peter-morken/kids-disc-player/cad/stl/housing.stl

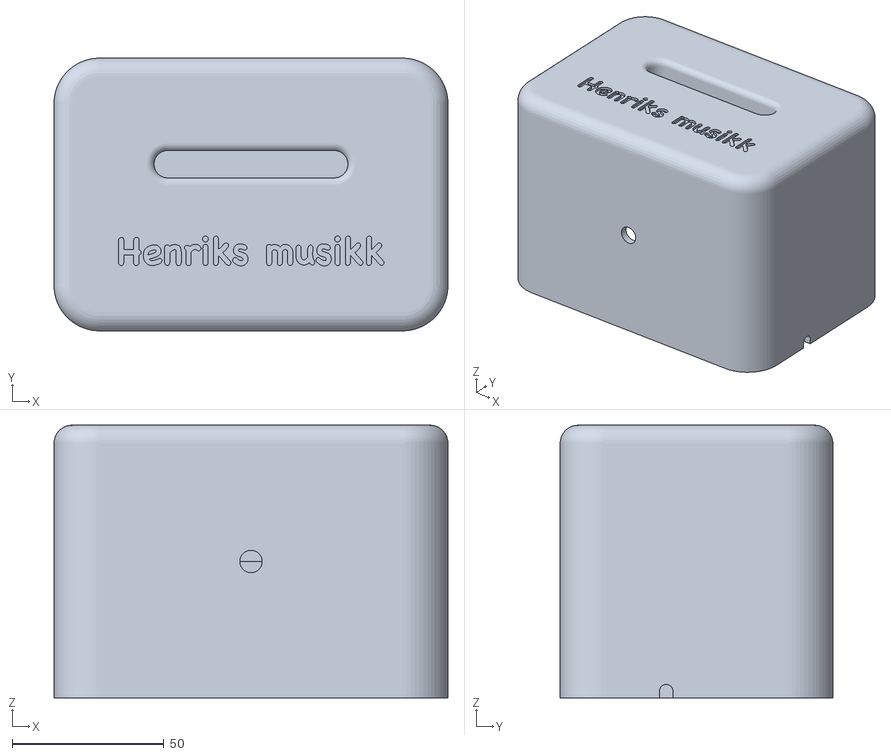
[picture p1: CAD file, 2026-11-07]
cad/stl/housing.stl
130.0 x 90.0 x 90.0
