peter-morken/kids-disc-player/cad/toddler-music-box.step

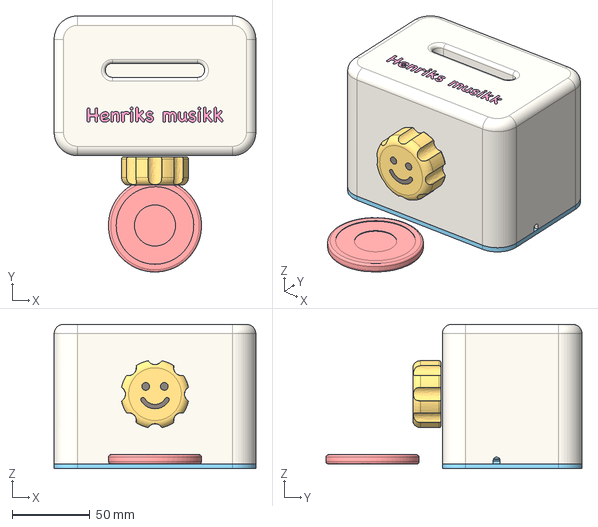
[picture p2: CAD file, 2026-11-07]
cad/toddler-music-box.step
130.0 x 165.0 x 93.0 mm
