peter-morken/kids-disc-player/cad/stl/name-text.stl

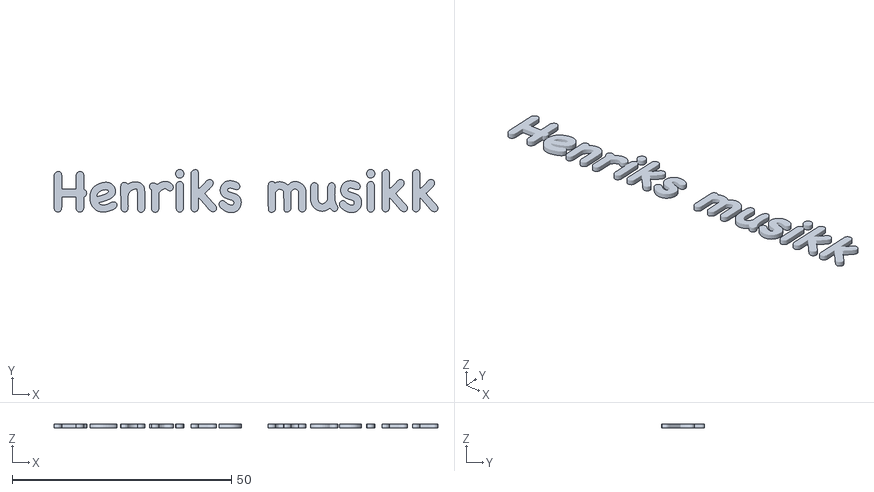
[picture p3: CAD file, 2026-11-07]
cad/stl/name-text.stl
87.7 x 9.89 x 1.00
