peter-morken/kids-disc-player/cad/stl/knob-face.stl

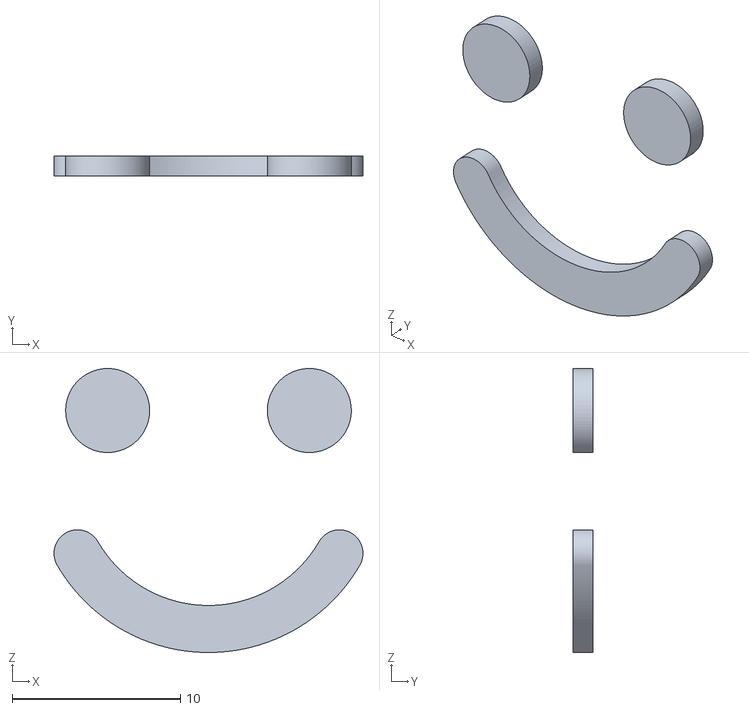
[picture p4: CAD file, 2026-11-07]
cad/stl/knob-face.stl
18.4 x 1.20 x 16.9
