peter-morken/kids-disc-player/cad/stl/knob.stl

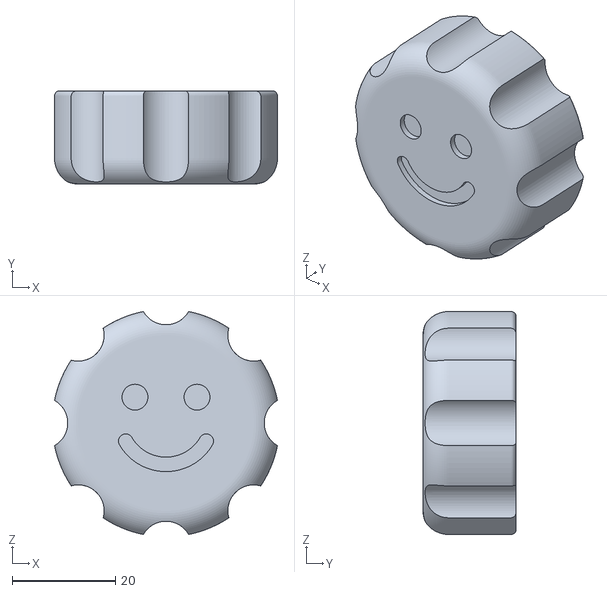
[picture p5: CAD file, 2026-11-07]
cad/stl/knob.stl
43.1 x 18.0 x 43.1
