peter-morken/kids-disc-player/cad/stl/base.stl

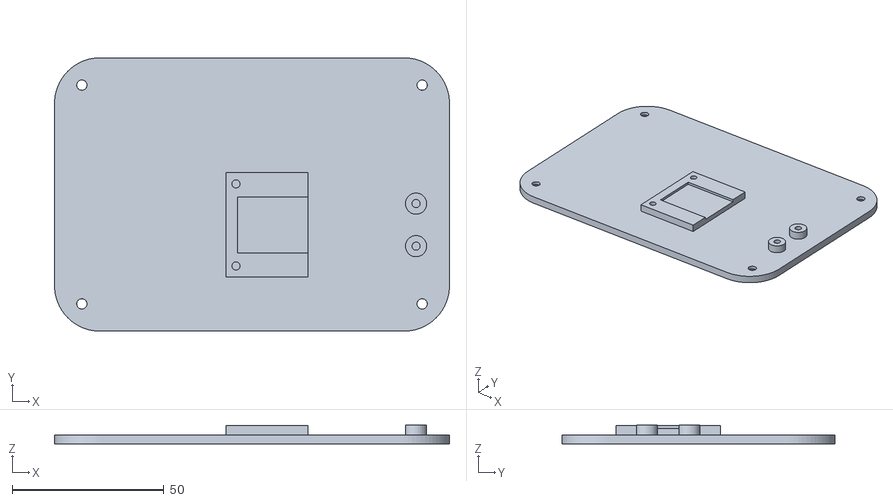
[picture p6: CAD file, 2026-11-07]
cad/stl/base.stl
130.0 x 90.0 x 6.20
