peter-morken/kids-disc-player/cad/stl/disc.stl

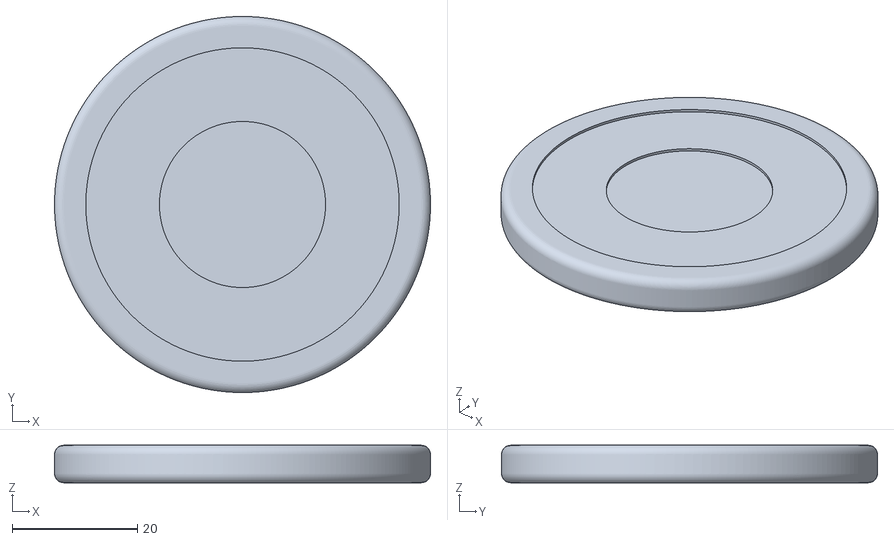
[picture p7: CAD file, 2026-11-07]
cad/stl/disc.stl
60.0 x 60.0 x 6.00
