peter-morken/kids-disc-player/cad/stl/cable-clamp.stl

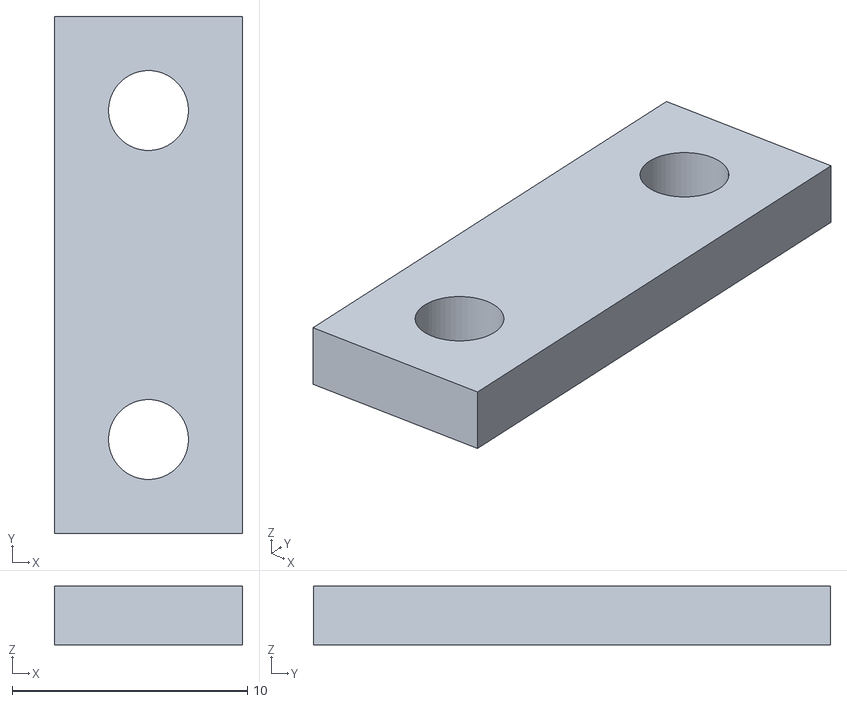
[picture p8: CAD file, 2026-11-07]
cad/stl/cable-clamp.stl
8.00 x 22.0 x 2.50
