peter-morken/kids-disc-player/cad/stl/esp-clamp.stl

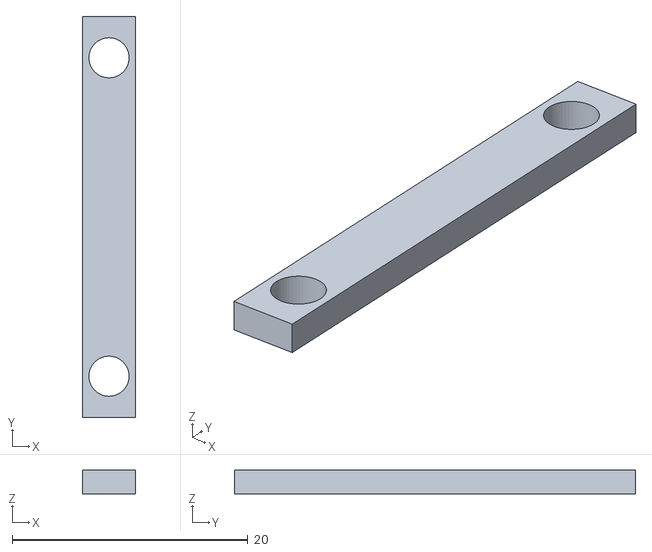
[picture p9: CAD file, 2026-11-07]
cad/stl/esp-clamp.stl
4.50 x 34.0 x 2.00
