peter-morken/kids-disc-player/(list of files, cad)

Other CAD files:
cad/toddler-music-box.3mf
