peter-morken/kids-disc-player/firmware/src/github_root_cas.h

#pragma once
// Root CAs trusted for firmware downloads from GitHub Releases.
// github.com and its release-asset CDN currently chain to Sectigo/USERTrust
// or DigiCert. The others are there so a change of CA by GitHub does not cut
// a device in the field off from updates. Source: Mozilla root store
// (Debian ca-certificates). Regenerate with tools/gen_root_cas.sh.

static const char kGithubRootCAs[] =
    // USERTrust_ECC_Certification_Authority
    "-----BEGIN CERTIFICATE-----\n"
    "MIICjzCCAhWgAwIBAgIQXIuZxVqUxdJxVt7NiYDMJjAKBggqhkjOPQQDAzCBiDEL\n"
    "MAkGA1UEBhMCVVMxEzARBgNVBAgTCk5ldyBKZXJzZXkxFDASBgNVBAcTC0plcnNl\n"
    "eSBDaXR5MR4wHAYDVQQKExVUaGUgVVNFUlRSVVNUIE5ldHdvcmsxLjAsBgNVBAMT\n"
    "JVVTRVJUcnVzdCBFQ0MgQ2VydGlmaWNhdGlvbiBBdXRob3JpdHkwHhcNMTAwMjAx\n"
    "MDAwMDAwWhcNMzgwMTE4MjM1OTU5WjCBiDELMAkGA1UEBhMCVVMxEzARBgNVBAgT\n"
    "Ck5ldyBKZXJzZXkxFDASBgNVBAcTC0plcnNleSBDaXR5MR4wHAYDVQQKExVUaGUg\n"
    "VVNFUlRSVVNUIE5ldHdvcmsxLjAsBgNVBAMTJVVTRVJUcnVzdCBFQ0MgQ2VydGlm\n"
    "aWNhdGlvbiBBdXRob3JpdHkwdjAQBgcqhkjOPQIBBgUrgQQAIgNiAAQarFRaqflo\n"
    "I+d61SRvU8Za2EurxtW20eZzca7dnNYMYf3boIkDuAUU7FfO7l0/4iGzzvfUinng\n"
    "o4N+LZfQYcTxmdwlkWOrfzCjtHDix6EznPO/LlxTsV+zfTJ/ijTjeXmjQjBAMB0G\n"
    "A1UdDgQWBBQ64QmG1M8ZwpZ2dEl23OA1xmNjmjAOBgNVHQ8BAf8EBAMCAQYwDwYD\n"
    "VR0TAQH/BAUwAwEB/zAKBggqhkjOPQQDAwNoADBlAjA2Z6EWCNzklwBBHU6+4WMB\n"
    "zzuqQhFkoJ2UOQIReVx7Hfpkue4WQrO/isIJxOzksU0CMQDpKmFHjFJKS04YcPbW\n"
    "RNZu9YO6bVi9JNlWSOrvxKJGgYhqOkbRqZtNyWHa0V1Xahg=\n"
    "-----END CERTIFICATE-----\n"
    // USERTrust_RSA_Certification_Authority
    "-----BEGIN CERTIFICATE-----\n"
    "MIIF3jCCA8agAwIBAgIQAf1tMPyjylGoG7xkDjUDLTANBgkqhkiG9w0BAQwFADCB\n"
    "iDELMAkGA1UEBhMCVVMxEzARBgNVBAgTCk5ldyBKZXJzZXkxFDASBgNVBAcTC0pl\n"
    "cnNleSBDaXR5MR4wHAYDVQQKExVUaGUgVVNFUlRSVVNUIE5ldHdvcmsxLjAsBgNV\n"
    "BAMTJVVTRVJUcnVzdCBSU0EgQ2VydGlmaWNhdGlvbiBBdXRob3JpdHkwHhcNMTAw\n"
    "MjAxMDAwMDAwWhcNMzgwMTE4MjM1OTU5WjCBiDELMAkGA1UEBhMCVVMxEzARBgNV\n"
    "BAgTCk5ldyBKZXJzZXkxFDASBgNVBAcTC0plcnNleSBDaXR5MR4wHAYDVQQKExVU\n"
    "aGUgVVNFUlRSVVNUIE5ldHdvcmsxLjAsBgNVBAMTJVVTRVJUcnVzdCBSU0EgQ2Vy\n"
    "dGlmaWNhdGlvbiBBdXRob3JpdHkwggIiMA0GCSqGSIb3DQEBAQUAA4ICDwAwggIK\n"
    "AoICAQCAEmUXNg7D2wiz0KxXDXbtzSfTTK1Qg2HiqiBNCS1kCdzOiZ/MPans9s/B\n"
    "3PHTsdZ7NygRK0faOca8Ohm0X6a9fZ2jY0K2dvKpOyuR+OJv0OwWIJAJPuLodMkY\n"
    "tJHUYmTbf6MG8YgYapAiPLz+E/CHFHv25B+O1ORRxhFnRghRy4YUVD+8M/5+bJz/\n"
    "Fp0YvVGONaanZshyZ9shZrHUm3gDwFA66Mzw3LyeTP6vBZY1H1dat//O+T23LLb2\n"
    "VN3I5xI6Ta5MirdcmrS3ID3KfyI0rn47aGYBROcBTkZTmzNg95S+UzeQc0PzMsNT\n"
    "79uq/nROacdrjGCT3sTHDN/hMq7MkztReJVni+49Vv4M0GkPGw/zJSZrM233bkf6\n"
    "c0Plfg6lZrEpfDKEY1WJxA3Bk1QwGROs0303p+tdOmw1XNtB1xLaqUkL39iAigmT\n"
    "Yo61Zs8liM2EuLE/pDkP2QKe6xJMlXzzawWpXhaDzLhn4ugTncxbgtNMs+1b/97l\n"
    "c6wjOy0AvzVVdAlJ2ElYGn+SNuZRkg7zJn0cTRe8yexDJtC/QV9AqURE9JnnV4ee\n"
    "UB9XVKg+/XRjL7FQZQnmWEIuQxpMtPAlR1n6BB6T1CZGSlCBst6+eLf8ZxXhyVeE\n"
    "Hg9j1uliutZfVS7qXMYoCAQlObgOK6nyTJccBz8NUvXt7y+CDwIDAQABo0IwQDAd\n"
    "BgNVHQ4EFgQUU3m/WqorSs9UgOHYm8Cd8rIDZsswDgYDVR0PAQH/BAQDAgEGMA8G\n"
    "A1UdEwEB/wQFMAMBAf8wDQYJKoZIhvcNAQEMBQADggIBAFzUfA3P9wF9QZllDHPF\n"
    "Up/L+M+ZBn8b2kMVn54CVVeWFPFSPCeHlCjtHzoBN6J2/FNQwISbxmtOuowhT6KO\n"
    "VWKR82kV2LyI48SqC/3vqOlLVSoGIG1VeCkZ7l8wXEskEVX/JJpuXior7gtNn3/3\n"
    "ATiUFJVDBwn7YKnuHKsSjKCaXqeYalltiz8I+8jRRa8YFWSQEg9zKC7F4iRO/Fjs\n"
    "8PRF/iKz6y+O0tlFYQXBl2+odnKPi4w2r78NBc5xjeambx9spnFixdjQg3IM8WcR\n"
    "iQycE0xyNN+81XHfqnHd4blsjDwSXWXavVcStkNr/+XeTWYRUc+ZruwXtuhxkYze\n"
    "Sf7dNXGiFSeUHM9h4ya7b6NnJSFd5t0dCy5oGzuCr+yDZ4XUmFF0sbmZgIn/f3gZ\n"
    "XHlKYC6SQK5MNyosycdiyA5d9zZbyuAlJQG03RoHnHcAP9Dc1ew91Pq7P8yF1m9/\n"
    "qS3fuQL39ZeatTXaw2ewh0qpKJ4jjv9cJ2vhsE/zB+4ALtRZh8tSQZXq9EfX7mRB\n"
    "VXyNWQKV3WKdwrnuWih0hKWbt5DHDAff9Yk2dDLWKMGwsAvgnEzDHNb842m1R0aB\n"
    "L6KCq9NjRHDEjf8tM7qtj3u1cIiuPhnPQCjY/MiQu12ZIvVS5ljFH4gxQ+6IHdfG\n"
    "jjxDah2nGN59PRbxYvnKkKj9\n"
    "-----END CERTIFICATE-----\n"
    // Sectigo_Public_Server_Authentication_Root_E46
    "-----BEGIN CERTIFICATE-----\n"
    "MIICOjCCAcGgAwIBAgIQQvLM2htpN0RfFf51KBC49DAKBggqhkjOPQQDAzBfMQsw\n"
    "CQYDVQQGEwJHQjEYMBYGA1UEChMPU2VjdGlnbyBMaW1pdGVkMTYwNAYDVQQDEy1T\n"
    "ZWN0aWdvIFB1YmxpYyBTZXJ2ZXIgQXV0aGVudGljYXRpb24gUm9vdCBFNDYwHhcN\n"
    "MjEwMzIyMDAwMDAwWhcNNDYwMzIxMjM1OTU5WjBfMQswCQYDVQQGEwJHQjEYMBYG\n"
    "A1UEChMPU2VjdGlnbyBMaW1pdGVkMTYwNAYDVQQDEy1TZWN0aWdvIFB1YmxpYyBT\n"
    "ZXJ2ZXIgQXV0aGVudGljYXRpb24gUm9vdCBFNDYwdjAQBgcqhkjOPQIBBgUrgQQA\n"
    "IgNiAAR2+pmpbiDt+dd34wc7qNs9Xzjoq1WmVk/WSOrsfy2qw7LFeeyZYX8QeccC\n"
    "WvkEN/U0NSt3zn8gj1KjAIns1aeibVvjS5KToID1AZTc8GgHHs3u/iVStSBDHBv+\n"
    "6xnOQ6OjQjBAMB0GA1UdDgQWBBTRItpMWfFLXyY4qp3W7usNw/upYTAOBgNVHQ8B\n"
    "Af8EBAMCAYYwDwYDVR0TAQH/BAUwAwEB/zAKBggqhkjOPQQDAwNnADBkAjAn7qRa\n"
    "qCG76UeXlImldCBteU/IvZNeWBj7LRoAasm4PdCkT0RHlAFWovgzJQxC36oCMB3q\n"
    "4S6ILuH5px0CMk7yn2xVdOOurvulGu7t0vzCAxHrRVxgED1cf5kDW21USAGKcw==\n"
    "-----END CERTIFICATE-----\n"
    // Sectigo_Public_Server_Authentication_Root_R46
    "-----BEGIN CERTIFICATE-----\n"
    "MIIFijCCA3KgAwIBAgIQdY39i658BwD6qSWn4cetFDANBgkqhkiG9w0BAQwFADBf\n"
    "MQswCQYDVQQGEwJHQjEYMBYGA1UEChMPU2VjdGlnbyBMaW1pdGVkMTYwNAYDVQQD\n"
    "Ey1TZWN0aWdvIFB1YmxpYyBTZXJ2ZXIgQXV0aGVudGljYXRpb24gUm9vdCBSNDYw\n"
    "HhcNMjEwMzIyMDAwMDAwWhcNNDYwMzIxMjM1OTU5WjBfMQswCQYDVQQGEwJHQjEY\n"
    "MBYGA1UEChMPU2VjdGlnbyBMaW1pdGVkMTYwNAYDVQQDEy1TZWN0aWdvIFB1Ymxp\n"
    "YyBTZXJ2ZXIgQXV0aGVudGljYXRpb24gUm9vdCBSNDYwggIiMA0GCSqGSIb3DQEB\n"
    "AQUAA4ICDwAwggIKAoICAQCTvtU2UnXYASOgHEdCSe5jtrch/cSV1UgrJnwUUxDa\n"
    "ef0rty2k1Cz66jLdScK5vQ9IPXtamFSvnl0xdE8H/FAh3aTPaE8bEmNtJZlMKpnz\n"
    "SDBh+oF8HqcIStw+KxwfGExxqjWMrfhu6DtK2eWUAtaJhBOqbchPM8xQljeSM9xf\n"
    "iOefVNlI8JhD1mb9nxc4Q8UBUQvX4yMPFF1bFOdLvt30yNoDN9HWOaEhUTCDsG3X\n"
    "ME6WW5HwcCSrv0WBZEMNvSE6Lzzpng3LILVCJ8zab5vuZDCQOc2TZYEhMbUjUDM3\n"
    "IuM47fgxMMxF/mL50V0yeUKH32rMVhlATc6qu/m1dkmU8Sf4kaWD5QazYw6A3OAS\n"
    "VYCmO2a0OYctyPDQ0RTp5A1NDvZdV3LFOxxHVp3i1fuBYYzMTYCQNFu31xR13NgE\n"
    "SJ/AwSiItOkcyqex8Va3e0lMWeUgFaiEAin6OJRpmkkGj80feRQXEgyDet4fsZfu\n"
    "+Zd4KKTIRJLpfSYFplhym3kT2BFfrsU4YjRosoYwjviQYZ4ybPUHNs2iTG7sijbt\n"
    "8uaZFURww3y8nDnAtOFr94MlI1fZEoDlSfB1D++N6xybVCi0ITz8fAr/73trdf+L\n"
    "HaAZBav6+CuBQug4urv7qv094PPK306Xlynt8xhW6aWWrL3DkJiy4Pmi1KZHQ3xt\n"
    "zwIDAQABo0IwQDAdBgNVHQ4EFgQUVnNYZJX5khqwEioEYnmhQBWIIUkwDgYDVR0P\n"
    "AQH/BAQDAgGGMA8GA1UdEwEB/wQFMAMBAf8wDQYJKoZIhvcNAQEMBQADggIBAC9c\n"
    "mTz8Bl6MlC5w6tIyMY208FHVvArzZJ8HXtXBc2hkeqK5Duj5XYUtqDdFqij0lgVQ\n"
    "YKlJfp/imTYpE0RHap1VIDzYm/EDMrraQKFz6oOht0SmDpkBm+S8f74TlH7Kph52\n"
    "gDY9hAaLMyZlbcp+nv4fjFg4exqDsQ+8FxG75gbMY/qB8oFM2gsQa6H61SilzwZA\n"
    "Fv97fRheORKkU55+MkIQpiGRqRxOF3yEvJ+M0ejf5lG5Nkc/kLnHvALcWxxPDkjB\n"
    "JYOcCj+esQMzEhonrPcibCTRAUH4WAP+JWgiH5paPHxsnnVI84HxZmduTILA7rpX\n"
    "DhjvLpr3Etiga+kFpaHpaPi8TD8SHkXoUsCjvxInebnMMTzD9joiFgOgyY9mpFui\n"
    "TdaBJQbpdqQACj7LzTWb4OE4y2BThihCQRxEV+ioratF4yUQvNs+ZUH7G6aXD+u5\n"
    "dHn5HrwdVw1Hr8Mvn4dGp+smWg9WY7ViYG4A++MnESLn/pmPNPW56MORcr3Ywx65\n"
    "LvKRRFHQV80MNNVIIb/bE/FmJUNS0nAiNs2fxBx1IK1jcmMGDw4nztJqDby1ORrp\n"
    "0XZ60Vzk50lJLVU3aPAaOpg+VBeHVOmmJ1CJeyAvP/+/oYtKR5j/K3tJPsMpRmAY\n"
    "QqszKbrAKbkTidOIijlBO8n9pu0f9GBj39ItVQGL\n"
    "-----END CERTIFICATE-----\n"
    // DigiCert_Global_Root_G2
    "-----BEGIN CERTIFICATE-----\n"
    "MIIDjjCCAnagAwIBAgIQAzrx5qcRqaC7KGSxHQn65TANBgkqhkiG9w0BAQsFADBh\n"
    "MQswCQYDVQQGEwJVUzEVMBMGA1UEChMMRGlnaUNlcnQgSW5jMRkwFwYDVQQLExB3\n"
    "d3cuZGlnaWNlcnQuY29tMSAwHgYDVQQDExdEaWdpQ2VydCBHbG9iYWwgUm9vdCBH\n"
    "MjAeFw0xMzA4MDExMjAwMDBaFw0zODAxMTUxMjAwMDBaMGExCzAJBgNVBAYTAlVT\n"
    "MRUwEwYDVQQKEwxEaWdpQ2VydCBJbmMxGTAXBgNVBAsTEHd3dy5kaWdpY2VydC5j\n"
    "b20xIDAeBgNVBAMTF0RpZ2lDZXJ0IEdsb2JhbCBSb290IEcyMIIBIjANBgkqhkiG\n"
    "9w0BAQEFAAOCAQ8AMIIBCgKCAQEAuzfNNNx7a8myaJCtSnX/RrohCgiN9RlUyfuI\n"
    "2/Ou8jqJkTx65qsGGmvPrC3oXgkkRLpimn7Wo6h+4FR1IAWsULecYxpsMNzaHxmx\n"
    "1x7e/dfgy5SDN67sH0NO3Xss0r0upS/kqbitOtSZpLYl6ZtrAGCSYP9PIUkY92eQ\n"
    "q2EGnI/yuum06ZIya7XzV+hdG82MHauVBJVJ8zUtluNJbd134/tJS7SsVQepj5Wz\n"
    "tCO7TG1F8PapspUwtP1MVYwnSlcUfIKdzXOS0xZKBgyMUNGPHgm+F6HmIcr9g+UQ\n"
    "vIOlCsRnKPZzFBQ9RnbDhxSJITRNrw9FDKZJobq7nMWxM4MphQIDAQABo0IwQDAP\n"
    "BgNVHRMBAf8EBTADAQH/MA4GA1UdDwEB/wQEAwIBhjAdBgNVHQ4EFgQUTiJUIBiV\n"
    "5uNu5g/6+rkS7QYXjzkwDQYJKoZIhvcNAQELBQADggEBAGBnKJRvDkhj6zHd6mcY\n"
    "1Yl9PMWLSn/pvtsrF9+wX3N3KjITOYFnQoQj8kVnNeyIv/iPsGEMNKSuIEyExtv4\n"
    "NeF22d+mQrvHRAiGfzZ0JFrabA0UWTW98kndth/Jsw1HKj2ZL7tcu7XUIOGZX1NG\n"
    "Fdtom/DzMNU+MeKNhJ7jitralj41E6Vf8PlwUHBHQRFXGU7Aj64GxJUTFy8bJZ91\n"
    "8rGOmaFvE7FBcf6IKshPECBV1/MUReXgRPTqh5Uykw7+U0b6LJ3/iyK5S9kJRaTe\n"
    "pLiaWN0bfVKfjllDiIGknibVb63dDcY3fe0Dkhvld1927jyNxF1WW6LZZm6zNTfl\n"
    "MrY=\n"
    "-----END CERTIFICATE-----\n"
    // DigiCert_Global_Root_G3
    "-----BEGIN CERTIFICATE-----\n"
    "MIICPzCCAcWgAwIBAgIQBVVWvPJepDU1w6QP1atFcjAKBggqhkjOPQQDAzBhMQsw\n"
    "CQYDVQQGEwJVUzEVMBMGA1UEChMMRGlnaUNlcnQgSW5jMRkwFwYDVQQLExB3d3cu\n"
    "ZGlnaWNlcnQuY29tMSAwHgYDVQQDExdEaWdpQ2VydCBHbG9iYWwgUm9vdCBHMzAe\n"
    "Fw0xMzA4MDExMjAwMDBaFw0zODAxMTUxMjAwMDBaMGExCzAJBgNVBAYTAlVTMRUw\n"
    "EwYDVQQKEwxEaWdpQ2VydCBJbmMxGTAXBgNVBAsTEHd3dy5kaWdpY2VydC5jb20x\n"
    "IDAeBgNVBAMTF0RpZ2lDZXJ0IEdsb2JhbCBSb290IEczMHYwEAYHKoZIzj0CAQYF\n"
    "K4EEACIDYgAE3afZu4q4C/sLfyHS8L6+c/MzXRq8NOrexpu80JX28MzQC7phW1FG\n"
    "fp4tn+6OYwwX7Adw9c+ELkCDnOg/QW07rdOkFFk2eJ0DQ+4QE2xy3q6Ip6FrtUPO\n"
    "Z9wj/wMco+I+o0IwQDAPBgNVHRMBAf8EBTADAQH/MA4GA1UdDwEB/wQEAwIBhjAd\n"
    "BgNVHQ4EFgQUs9tIpPmhxdiuNkHMEWNpYim8S8YwCgYIKoZIzj0EAwMDaAAwZQIx\n"
    "AK288mw/EkrRLTnDCgmXc/SINoyIJ7vmiI1Qhadj+Z4y3maTD/HMsQmP3Wyr+mt/\n"
    "oAIwOWZbwmSNuJ5Q3KjVSaLtx9zRSX8XAbjIho9OjIgrqJqpisXRAL34VOKa5Vt8\n"
    "sycX\n"
    "-----END CERTIFICATE-----\n"
    // ISRG_Root_X1
    "-----BEGIN CERTIFICATE-----\n"
    "MIIFazCCA1OgAwIBAgIRAIIQz7DSQONZRGPgu2OCiwAwDQYJKoZIhvcNAQELBQAw\n"
    "TzELMAkGA1UEBhMCVVMxKTAnBgNVBAoTIEludGVybmV0IFNlY3VyaXR5IFJlc2Vh\n"
    "cmNoIEdyb3VwMRUwEwYDVQQDEwxJU1JHIFJvb3QgWDEwHhcNMTUwNjA0MTEwNDM4\n"
    "WhcNMzUwNjA0MTEwNDM4WjBPMQswCQYDVQQGEwJVUzEpMCcGA1UEChMgSW50ZXJu\n"
    "ZXQgU2VjdXJpdHkgUmVzZWFyY2ggR3JvdXAxFTATBgNVBAMTDElTUkcgUm9vdCBY\n"
    "MTCCAiIwDQYJKoZIhvcNAQEBBQADggIPADCCAgoCggIBAK3oJHP0FDfzm54rVygc\n"
    "h77ct984kIxuPOZXoHj3dcKi/vVqbvYATyjb3miGbESTtrFj/RQSa78f0uoxmyF+\n"
    "0TM8ukj13Xnfs7j/EvEhmkvBioZxaUpmZmyPfjxwv60pIgbz5MDmgK7iS4+3mX6U\n"
    "A5/TR5d8mUgjU+g4rk8Kb4Mu0UlXjIB0ttov0DiNewNwIRt18jA8+o+u3dpjq+sW\n"
    "T8KOEUt+zwvo/7V3LvSye0rgTBIlDHCNAymg4VMk7BPZ7hm/ELNKjD+Jo2FR3qyH\n"
    "B5T0Y3HsLuJvW5iB4YlcNHlsdu87kGJ55tukmi8mxdAQ4Q7e2RCOFvu396j3x+UC\n"
    "B5iPNgiV5+I3lg02dZ77DnKxHZu8A/lJBdiB3QW0KtZB6awBdpUKD9jf1b0SHzUv\n"
    "KBds0pjBqAlkd25HN7rOrFleaJ1/ctaJxQZBKT5ZPt0m9STJEadao0xAH0ahmbWn\n"
    "OlFuhjuefXKnEgV4We0+UXgVCwOPjdAvBbI+e0ocS3MFEvzG6uBQE3xDk3SzynTn\n"
    "jh8BCNAw1FtxNrQHusEwMFxIt4I7mKZ9YIqioymCzLq9gwQbooMDQaHWBfEbwrbw\n"
    "qHyGO0aoSCqI3Haadr8faqU9GY/rOPNk3sgrDQoo//fb4hVC1CLQJ13hef4Y53CI\n"
    "rU7m2Ys6xt0nUW7/vGT1M0NPAgMBAAGjQjBAMA4GA1UdDwEB/wQEAwIBBjAPBgNV\n"
    "HRMBAf8EBTADAQH/MB0GA1UdDgQWBBR5tFnme7bl5AFzgAiIyBpY9umbbjANBgkq\n"
    "hkiG9w0BAQsFAAOCAgEAVR9YqbyyqFDQDLHYGmkgJykIrGF1XIpu+ILlaS/V9lZL\n"
    "ubhzEFnTIZd+50xx+7LSYK05qAvqFyFWhfFQDlnrzuBZ6brJFe+GnY+EgPbk6ZGQ\n"
    "3BebYhtF8GaV0nxvwuo77x/Py9auJ/GpsMiu/X1+mvoiBOv/2X/qkSsisRcOj/KK\n"
    "NFtY2PwByVS5uCbMiogziUwthDyC3+6WVwW6LLv3xLfHTjuCvjHIInNzktHCgKQ5\n"
    "ORAzI4JMPJ+GslWYHb4phowim57iaztXOoJwTdwJx4nLCgdNbOhdjsnvzqvHu7Ur\n"
    "TkXWStAmzOVyyghqpZXjFaH3pO3JLF+l+/+sKAIuvtd7u+Nxe5AW0wdeRlN8NwdC\n"
    "jNPElpzVmbUq4JUagEiuTDkHzsxHpFKVK7q4+63SM1N95R1NbdWhscdCb+ZAJzVc\n"
    "oyi3B43njTOQ5yOf+1CceWxG1bQVs5ZufpsMljq4Ui0/1lvh+wjChP4kqKOJ2qxq\n"
    "4RgqsahDYVvTH9w7jXbyLeiNdd8XM2w9U/t7y0Ff/9yi0GE44Za4rF2LN9d11TPA\n"
    "mRGunUHBcnWEvgJBQl9nJEiU0Zsnvgc/ubhPgXRR4Xq37Z0j4r7g1SgEEzwxA57d\n"
    "emyPxgcYxn/eR44/KJ4EBs+lVDR3veyJm+kXQ99b21/+jh5Xos1AnX5iItreGCc=\n"
    "-----END CERTIFICATE-----\n"
    // ISRG_Root_X2
    "-----BEGIN CERTIFICATE-----\n"
    "MIICGzCCAaGgAwIBAgIQQdKd0XLq7qeAwSxs6S+HUjAKBggqhkjOPQQDAzBPMQsw\n"
    "CQYDVQQGEwJVUzEpMCcGA1UEChMgSW50ZXJuZXQgU2VjdXJpdHkgUmVzZWFyY2gg\n"
    "R3JvdXAxFTATBgNVBAMTDElTUkcgUm9vdCBYMjAeFw0yMDA5MDQwMDAwMDBaFw00\n"
    "MDA5MTcxNjAwMDBaME8xCzAJBgNVBAYTAlVTMSkwJwYDVQQKEyBJbnRlcm5ldCBT\n"
    "ZWN1cml0eSBSZXNlYXJjaCBHcm91cDEVMBMGA1UEAxMMSVNSRyBSb290IFgyMHYw\n"
    "EAYHKoZIzj0CAQYFK4EEACIDYgAEzZvVn4CDCuwJSvMWSj5cz3es3mcFDR0HttwW\n"
    "+1qLFNvicWDEukWVEYmO6gbf9yoWHKS5xcUy4APgHoIYOIvXRdgKam7mAHf7AlF9\n"
    "ItgKbppbd9/w+kHsOdx1ymgHDB/qo0IwQDAOBgNVHQ8BAf8EBAMCAQYwDwYDVR0T\n"
    "AQH/BAUwAwEB/zAdBgNVHQ4EFgQUfEKWrt5LSDv6kviejM9ti6lyN5UwCgYIKoZI\n"
    "zj0EAwMDaAAwZQIwe3lORlCEwkSHRhtFcP9Ymd70/aTSVaYgLXTWNLxBo1BfASdW\n"
    "tL4ndQavEi51mI38AjEAi/V3bNTIZargCyzuFJ0nN6T5U6VR5CmD1/iQMVtCnwr1\n"
    "/q4AaOeMSQ+2b1tbFfLn\n"
    "-----END CERTIFICATE-----\n"
    // GTS_Root_R1
    "-----BEGIN CERTIFICATE-----\n"
    "MIIFVzCCAz+gAwIBAgINAgPlk28xsBNJiGuiFzANBgkqhkiG9w0BAQwFADBHMQsw\n"
    "CQYDVQQGEwJVUzEiMCAGA1UEChMZR29vZ2xlIFRydXN0IFNlcnZpY2VzIExMQzEU\n"
    "MBIGA1UEAxMLR1RTIFJvb3QgUjEwHhcNMTYwNjIyMDAwMDAwWhcNMzYwNjIyMDAw\n"
    "MDAwWjBHMQswCQYDVQQGEwJVUzEiMCAGA1UEChMZR29vZ2xlIFRydXN0IFNlcnZp\n"
    "Y2VzIExMQzEUMBIGA1UEAxMLR1RTIFJvb3QgUjEwggIiMA0GCSqGSIb3DQEBAQUA\n"
    "A4ICDwAwggIKAoICAQC2EQKLHuOhd5s73L+UPreVp0A8of2C+X0yBoJx9vaMf/vo\n"
    "27xqLpeXo4xL+Sv2sfnOhB2x+cWX3u+58qPpvBKJXqeqUqv4IyfLpLGcY9vXmX7w\n"
    "Cl7raKb0xlpHDU0QM+NOsROjyBhsS+z8CZDfnWQpJSMHobTSPS5g4M/SCYe7zUjw\n"
    "TcLCeoiKu7rPWRnWr4+wB7CeMfGCwcDfLqZtbBkOtdh+JhpFAz2weaSUKK0Pfybl\n"
    "qAj+lug8aJRT7oM6iCsVlgmy4HqMLnXWnOunVmSPlk9orj2XwoSPwLxAwAtcvfaH\n"
    "szVsrBhQf4TgTM2S0yDpM7xSma8ytSmzJSq0SPly4cpk9+aCEI3oncKKiPo4Zor8\n"
    "Y/kB+Xj9e1x3+naH+uzfsQ55lVe0vSbv1gHR6xYKu44LtcXFilWr06zqkUspzBmk\n"
    "MiVOKvFlRNACzqrOSbTqn3yDsEB750Orp2yjj32JgfpMpf/VjsPOS+C12LOORc92\n"
    "wO1AK/1TD7Cn1TsNsYqiA94xrcx36m97PtbfkSIS5r762DL8EGMUUXLeXdYWk70p\n"
    "aDPvOmbsB4om3xPXV2V4J95eSRQAogB/mqghtqmxlbCluQ0WEdrHbEg8QOB+DVrN\n"
    "VjzRlwW5y0vtOUucxD/SVRNuJLDWcfr0wbrM7Rv1/oFB2ACYPTrIrnqYNxgFlQID\n"
    "AQABo0IwQDAOBgNVHQ8BAf8EBAMCAYYwDwYDVR0TAQH/BAUwAwEB/zAdBgNVHQ4E\n"
    "FgQU5K8rJnEaK0gnhS9SZizv8IkTcT4wDQYJKoZIhvcNAQEMBQADggIBAJ+qQibb\n"
    "C5u+/x6Wki4+omVKapi6Ist9wTrYggoGxval3sBOh2Z5ofmmWJyq+bXmYOfg6LEe\n"
    "QkEzCzc9zolwFcq1JKjPa7XSQCGYzyI0zzvFIoTgxQ6KfF2I5DUkzps+GlQebtuy\n"
    "h6f88/qBVRRiClmpIgUxPoLW7ttXNLwzldMXG+gnoot7TiYaelpkttGsN/H9oPM4\n"
    "7HLwEXWdyzRSjeZ2axfG34arJ45JK3VmgRAhpuo+9K4l/3wV3s6MJT/KYnAK9y8J\n"
    "ZgfIPxz88NtFMN9iiMG1D53Dn0reWVlHxYciNuaCp+0KueIHoI17eko8cdLiA6Ef\n"
    "MgfdG+RCzgwARWGAtQsgWSl4vflVy2PFPEz0tv/bal8xa5meLMFrUKTX5hgUvYU/\n"
    "Z6tGn6D/Qqc6f1zLXbBwHSs09dR2CQzreExZBfMzQsNhFRAbd03OIozUhfJFfbdT\n"
    "6u9AWpQKXCBfTkBdYiJ23//OYb2MI3jSNwLgjt7RETeJ9r/tSQdirpLsQBqvFAnZ\n"
    "0E6yove+7u7Y/9waLd64NnHi/Hm3lCXRSHNboTXns5lndcEZOitHTtNCjv0xyBZm\n"
    "2tIMPNuzjsmhDYAPexZ3FL//2wmUspO8IFgV6dtxQ/PeEMMA3KgqlbbC1j+Qa3bb\n"
    "bP6MvPJwNQzcmRk13NfIRmPVNnGuV/u3gm3c\n"
    "-----END CERTIFICATE-----\n"
    // GTS_Root_R4
    "-----BEGIN CERTIFICATE-----\n"
    "MIICCTCCAY6gAwIBAgINAgPlwGjvYxqccpBQUjAKBggqhkjOPQQDAzBHMQswCQYD\n"
    "VQQGEwJVUzEiMCAGA1UEChMZR29vZ2xlIFRydXN0IFNlcnZpY2VzIExMQzEUMBIG\n"
    "A1UEAxMLR1RTIFJvb3QgUjQwHhcNMTYwNjIyMDAwMDAwWhcNMzYwNjIyMDAwMDAw\n"
    "WjBHMQswCQYDVQQGEwJVUzEiMCAGA1UEChMZR29vZ2xlIFRydXN0IFNlcnZpY2Vz\n"
    "IExMQzEUMBIGA1UEAxMLR1RTIFJvb3QgUjQwdjAQBgcqhkjOPQIBBgUrgQQAIgNi\n"
    "AATzdHOnaItgrkO4NcWBMHtLSZ37wWHO5t5GvWvVYRg1rkDdc/eJkTBa6zzuhXyi\n"
    "QHY7qca4R9gq55KRanPpsXI5nymfopjTX15YhmUPoYRlBtHci8nHc8iMai/lxKvR\n"
    "HYqjQjBAMA4GA1UdDwEB/wQEAwIBhjAPBgNVHRMBAf8EBTADAQH/MB0GA1UdDgQW\n"
    "BBSATNbrdP9JNqPV2Py1PsVq8JQdjDAKBggqhkjOPQQDAwNpADBmAjEA6ED/g94D\n"
    "9J+uHXqnLrmvT/aDHQ4thQEd0dlq7A/Cr8deVl5c1RxYIigL9zC2L7F8AjEA8GE8\n"
    "p/SgguMh1YQdc4acLa/KNJvxn7kjNuK8YAOdgLOaVsjh4rsUecrNIdSUtUlD\n"
    "-----END CERTIFICATE-----\n"
    // Microsoft_RSA_Root_Certificate_Authority_2017
    "-----BEGIN CERTIFICATE-----\n"
    "MIIFqDCCA5CgAwIBAgIQHtOXCV/YtLNHcB6qvn9FszANBgkqhkiG9w0BAQwFADBl\n"
    "MQswCQYDVQQGEwJVUzEeMBwGA1UEChMVTWljcm9zb2Z0IENvcnBvcmF0aW9uMTYw\n"
    "NAYDVQQDEy1NaWNyb3NvZnQgUlNBIFJvb3QgQ2VydGlmaWNhdGUgQXV0aG9yaXR5\n"
    "IDIwMTcwHhcNMTkxMjE4MjI1MTIyWhcNNDIwNzE4MjMwMDIzWjBlMQswCQYDVQQG\n"
    "EwJVUzEeMBwGA1UEChMVTWljcm9zb2Z0IENvcnBvcmF0aW9uMTYwNAYDVQQDEy1N\n"
    "aWNyb3NvZnQgUlNBIFJvb3QgQ2VydGlmaWNhdGUgQXV0aG9yaXR5IDIwMTcwggIi\n"
    "MA0GCSqGSIb3DQEBAQUAA4ICDwAwggIKAoICAQDKW76UM4wplZEWCpW9R2LBifOZ\n"
    "Nt9GkMml7Xhqb0eRaPgnZ1AzHaGm++DlQ6OEAlcBXZxIQIJTELy/xztokLaCLeX0\n"
    "ZdDMbRnMlfl7rEqUrQ7eS0MdhweSE5CAg2Q1OQT85elss7YfUJQ4ZVBcF0a5toW1\n"
    "HLUX6NZFndiyJrDKxHBKrmCk3bPZ7Pw71VdyvD/IybLeS2v4I2wDwAW9lcfNcztm\n"
    "gGTjGqwu+UcF8ga2m3P1eDNbx6H7JyqhtJqRjJHTOoI+dkC0zVJhUXAoP8XFWvLJ\n"
    "jEm7FFtNyP9nTUwSlq31/niol4fX/V4ggNyhSyL71Imtus5Hl0dVe49FyGcohJUc\n"
    "aDDv70ngNXtk55iwlNpNhTs+VcQor1fznhPbRiefHqJeRIOkpcrVE7NLP8TjwuaG\n"
    "YaRSMLl6IE9vDzhTyzMMEyuP1pq9KsgtsRx9S1HKR9FIJ3Jdh+vVReZIZZ2vUpC6\n"
    "W6IYZVcSn2i51BVrlMRpIpj0M+Dt+VGOQVDJNE92kKz8OMHY4Xu54+OU4UZpyw4K\n"
    "UGsTuqwPN1q3ErWQgR5WrlcihtnJ0tHXUeOrO8ZV/R4O03QK0dqq6mm4lyiPSMQH\n"
    "+FJDOvTKVTUssKZqwJz58oHhEmrARdlns87/I6KJClTUFLkqqNfs+avNJVgyeY+Q\n"
    "W5g5xAgGwax/Dj0ApQIDAQABo1QwUjAOBgNVHQ8BAf8EBAMCAYYwDwYDVR0TAQH/\n"
    "BAUwAwEB/zAdBgNVHQ4EFgQUCctZf4aycI8awznjwNnpv7tNsiMwEAYJKwYBBAGC\n"
    "NxUBBAMCAQAwDQYJKoZIhvcNAQEMBQADggIBAKyvPl3CEZaJjqPnktaXFbgToqZC\n"
    "LgLNFgVZJ8og6Lq46BrsTaiXVq5lQ7GPAJtSzVXNUzltYkyLDVt8LkS/gxCP81OC\n"
    "gMNPOsduET/m4xaRhPtthH80dK2Jp86519efhGSSvpWhrQlTM93uCupKUY5vVau6\n"
    "tZRGrox/2KJQJWVggEbbMwSubLWYdFQl3JPk+ONVFT24bcMKpBLBaYVu32TxU5nh\n"
    "SnUgnZUP5NbcA/FZGOhHibJXWpS2qdgXKxdJ5XbLwVaZOjex/2kskZGT4d9Mozd2\n"
    "TaGf+G0eHdP67Pv0RR0Tbc/3WeUiJ3IrhvNXuzDtJE3cfVa7o7P4NHmJweDyAmH3\n"
    "pvwPuxwXC65B2Xy9J6P9LjrRk5Sxcx0ki69bIImtt2dmefU6xqaWM/5TkshGsRGR\n"
    "xpl/j8nWZjEgQRCHLQzWwa80mMpkg/sTV9HB8Dx6jKXB/ZUhoHHBk2dxEuqPiApp\n"
    "GWSZI1b7rCoucL5mxAyE7+WL85MB+GqQk2dLsmijtWKP6T+MejteD+eMuMZ87zf9\n"
    "dOLITzNy4ZQ5bb0Sr74MTnB8G2+NszKTc0QWbej09+CVgI+WXTik9KveCjCHk9hN\n"
    "AHFiRSdLOkKEW39lt2c0Ui2cFmuqqNh7o0JMcccMyj6D5KbvtwEwXlGjefVwaaZB\n"
    "RA+GsCyRxj3qrg+E\n"
    "-----END CERTIFICATE-----\n"
    // Microsoft_ECC_Root_Certificate_Authority_2017
    "-----BEGIN CERTIFICATE-----\n"
    "MIICWTCCAd+gAwIBAgIQZvI9r4fei7FK6gxXMQHC7DAKBggqhkjOPQQDAzBlMQsw\n"
    "CQYDVQQGEwJVUzEeMBwGA1UEChMVTWljcm9zb2Z0IENvcnBvcmF0aW9uMTYwNAYD\n"
    "VQQDEy1NaWNyb3NvZnQgRUNDIFJvb3QgQ2VydGlmaWNhdGUgQXV0aG9yaXR5IDIw\n"
    "MTcwHhcNMTkxMjE4MjMwNjQ1WhcNNDIwNzE4MjMxNjA0WjBlMQswCQYDVQQGEwJV\n"
    "UzEeMBwGA1UEChMVTWljcm9zb2Z0IENvcnBvcmF0aW9uMTYwNAYDVQQDEy1NaWNy\n"
    "b3NvZnQgRUNDIFJvb3QgQ2VydGlmaWNhdGUgQXV0aG9yaXR5IDIwMTcwdjAQBgcq\n"
    "hkjOPQIBBgUrgQQAIgNiAATUvD0CQnVBEyPNgASGAlEvaqiBYgtlzPbKnR5vSmZR\n"
    "ogPZnZH6thaxjG7efM3beaYvzrvOcS/lpaso7GMEZpn4+vKTEAXhgShC48Zo9OYb\n"
    "hGBKia/teQ87zvH2RPUBeMCjVDBSMA4GA1UdDwEB/wQEAwIBhjAPBgNVHRMBAf8E\n"
    "BTADAQH/MB0GA1UdDgQWBBTIy5lycFIM+Oa+sgRXKSrPQhDtNTAQBgkrBgEEAYI3\n"
    "FQEEAwIBADAKBggqhkjOPQQDAwNoADBlAjBY8k3qDPlfXu5gKcs68tvWMoQZP3zV\n"
    "L8KxzJOuULsJMsbG7X7JNpQS5GiFBqIb0C8CMQCZ6Ra0DvpWSNSkMBaReNtUjGUB\n"
    "iudQZsIxtzm6uBoiB078a1QWIP8rtedMDE2mT3M=\n"
    "-----END CERTIFICATE-----\n"
    ;
