peter-morken/kids-disc-player/(commit log)

2026-10-28 Initial kids disc player: ESP32 firmware, OpenSCAD enclosure and discs
    - ESP32 + PN532 reads an NDEF Spotify link from an NTAG disc and drives a
    Sonos speaker over its local UPnP API (same URI scheme as SoCo).
    - Insert plays, removal pauses, re-insert within 10 min resumes.
    - Host unit tests for NDEF parsing, link parsing, SOAP building and the
    insert/remove state machine.
    - Parametric OpenSCAD shell, base and disc; CI builds firmware and STLs.
    Claude-Session: https://claude.ai/code/session_01U7daFmj2kHodwQ4BdY4cyC
    [disc.scad, enclosure.scad, params.scad]
2026-10-28 Fix ESP32 build: rename config header; move CI actions to Node 24
    The firmware included "config.h" behind __has_include, but ESP-IDF ships
    headers with that name, so one of those was picked up instead and none of
    the player's settings were defined. Rename to player_config.h.
    Bump checkout/setup-python/cache/upload-artifact to their Node 24 majors
    to clear the Node.js 20 deprecation warning.
    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
    [main.cpp]
2026-10-28 Set up from a phone, find Sonos by room name, self-update from releases (#1)
    The device is going to a household where nobody can edit a header file or
    reflash it, so nothing household-specific is compiled in any more.
    - Setup portal (WiFiManager): on first boot or when the saved Wi-Fi is
    unreachable, the device opens an open "DiscPlayer-Setup" network where
    Wi-Fi, the Sonos room name and start volume are entered. Room/volume live
    in NVS. If the room can't be found at boot the portal opens in the
    background while the player keeps running.
    - Speaker discovery: SSDP finds any Sonos player, then GetZoneGroupState
    maps the room name to the controllable member (skipping the invisible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
    [board.h, github_root_cas.h, main.cpp, ota.cpp, ota.h, settings.cpp, settings.h]
2026-10-28 Add volume knob with parent-set cap, LED ring, and kid-proof disc handling (#2)
    Volume knob (EC11 encoder on the front face):
    - Steps of 2, never above the max volume. Above-cap volumes set elsewhere
    are left alone on "up" and dropped to the cap on "down".
    - Encoder and switch are sampled at 1 kHz in their own task, so turns
    aren't lost while the main loop waits on Sonos.
    - Holding the knob 5 s saves the speaker's current volume as the new max.
    A kid at the knob can only lower it that way; raising it needs the Sonos
    app or speaker buttons first. Max below 5 is rejected.
    - Each new disc starts at half the max. The setup page asks for the max
    instead of a start volume.
    LED ring (12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
    [enclosure.scad, knob.scad, params.scad]
2026-10-28 Add CAD previews: README pictures and printable STLs in the repo (#3)
    - tools/render_previews.sh renders cad/preview/*.png (assembly, cutaway,
    disc, knob) and exports binary STLs of every printable part to cad/stl/,
    where GitHub shows them in its 3D viewer.
    - New "cutaway" part in enclosure.scad shows the reader, ESP32 and LED
    ring; the assembly now uses the real knob and disc models and an opaque
    light shell, as recommended for the LED window.
    - CI renders with the same script and uploads the results. On PRs it fails
    if cad/*.scad changed without cad/preview or cad/stl changing. It checks
    for an update rather than byte equality, because OpenSCAD versions differ
    between machine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
    [base.stl, disc-embedded-tag.stl, disc-open-pocket.stl, enclosure.scad, knob.stl, shell.stl]
2026-10-28 Port to ESP32-S3 SuperMini and document the bill of materials (#4)
    The design targeted a classic ESP32 DevKit, but the boards on hand are
    ESP32-S3 SuperMinis.
    - PlatformIO env esp32s3 (esp32-s3-devkitc-1, 4 MB flash, USB CDC serial
    on the native USB port). CI and docs use the new env name.
    - Pins moved to the SuperMini's GPIO 1-13: PN532 on 8/9 (the S3's default
    I2C pins) with IRQ 7 and RST 6, knob on 4/5/10, ring data on 2. GPIO 3 is a
    strapping pin and stays free. The onboard-LED pin is gone: the SuperMini's
    LED is an addressable RGB LED, and the ring already gives feedback.
    - Enclosure cradle resized to 22.6 x 18.1 mm at a 4 mm standoff, with wires
    soldered straight to the pads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
    [base.stl, enclosure.scad, shell.stl]
2026-10-28 Add where-to-buy links to the bill of materials (#5)
    Each part gets an AliExpress search link (individual listings come and go),
    and the three parts still to buy also get a reference product from a
    regular shop. Notes now spell out the specs that matter: the ring's inner
    diameter range the LED pocket fits, 20 pulses / 20 detents for the encoder
    so every click registers, and NTAG21x rather than MIFARE Classic stickers.
    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
2026-10-28 Remove unverified where-to-buy links from the bill of materials (#6)
    The links couldn't be checked, so the BOM lists item names and the specs
    to match instead. The Notes column keeps the details that decide whether a
    part fits.
    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
2026-11-07 Add SolidCraft enclosure design: STLs, 3MF, STEP and source
    Final printable parts for the redesigned player: 75 mm 24-LED ring and
    threaded KY-040 behind the front wall, internal USB-C with cable clamp,
    round label recess on the discs, and multi-colour name and knob-face inlays.
    [base.stl, cable-clamp.stl, disc.stl, esp-clamp.stl, housing.stl, knob-face.stl, knob.stl, name-text.stl]
2026-11-07 Align firmware, BOM and docs with the SolidCraft enclosure and bought parts
    Firmware:
    - RING_LED_COUNT 24 for the 75 mm ring.
    - RING_FIRST_LED_OFFSET and RING_REVERSED in board.h map the gauge and
    spinner onto the ring however it was glued in (ringLed() in
    lib/discplayer, unit-tested).
    - Spinner keeps the same speed and quarter-turn tail on any LED count
    (spinnerHead(), unit-tested).
    - Compile-time check keeps the ring's worst case (full white) under
    300 mA; at brightness 40 with 24 LEDs it is about 250 mA.
    - KY-040: no code change. The full-step decoder suits a 20/20 encoder
    idling high; the internal pull-ups are harmless alongside the module's
    10k ones and needed on SW. Documen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
2026-11-07 Remove the superseded OpenSCAD design; SolidCraft files move to cad/
    The SolidCraft enclosure is the only design to print, so the repo now
    carries only its files:
    - cad/stl/ holds the SolidCraft STLs (byte-identical to cad/solidcraft/stl/),
    and the 3MF, STEP and .sc source move up to cad/.
    - Deleted: the OpenSCAD sources, their generated STLs and preview pictures,
    tools/render_previews.sh, and the CI job that rendered them. They don't fit
    the SolidCraft parts and remain in git history.
    - README, build.md and discs.md point at the new paths; the README drops the
    pictures of the old design. The bill of materials is unchanged.
    Cl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
    [base.stl, cable-clamp.stl, disc-embedded-tag.stl, disc-open-pocket.stl, disc.scad, disc.stl, enclosure.scad, esp-clamp.stl]
